Benemenn/autocrib/README.md

Die Dokumentation ist [hier](https://benemenn.github.io/autocrib/) einzusehen!
