Benemenn/autocrib/CAD/CoinSensorTray/CoinSensorTray.png

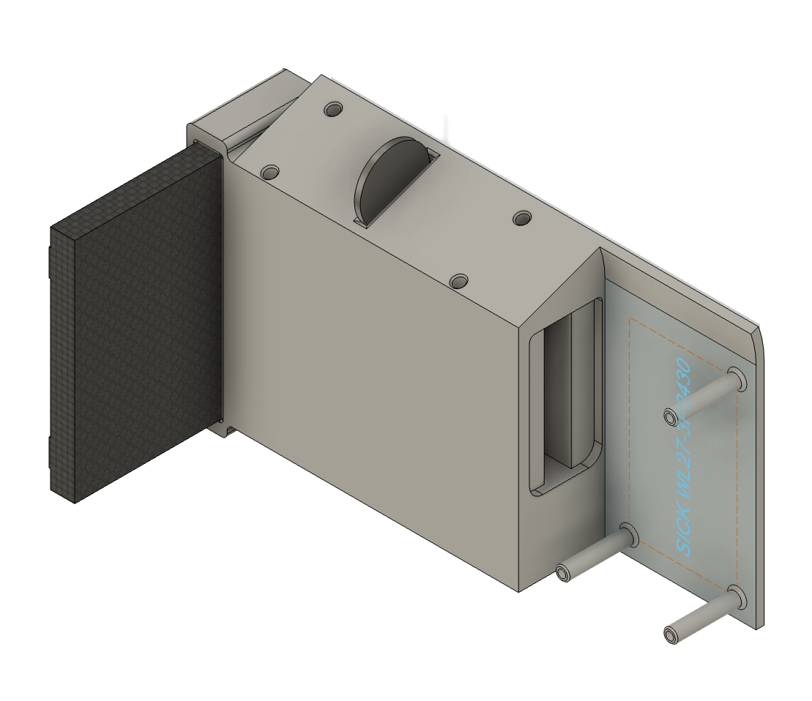
CAD/CoinSensorTray/CoinSensorTray.png
