Benemenn/autocrib/images/Kreppchen_ganz.jpeg

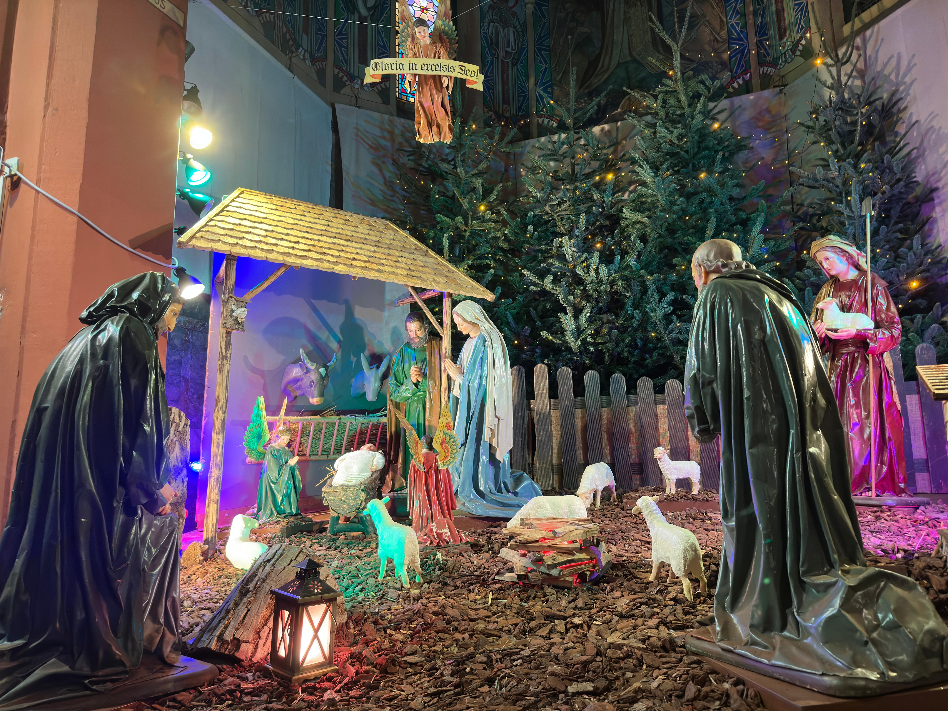
images/Kreppchen_ganz.jpeg
