Benemenn/autocrib/CAD/CoinSensorTray/CoinSensorTray v1.stl

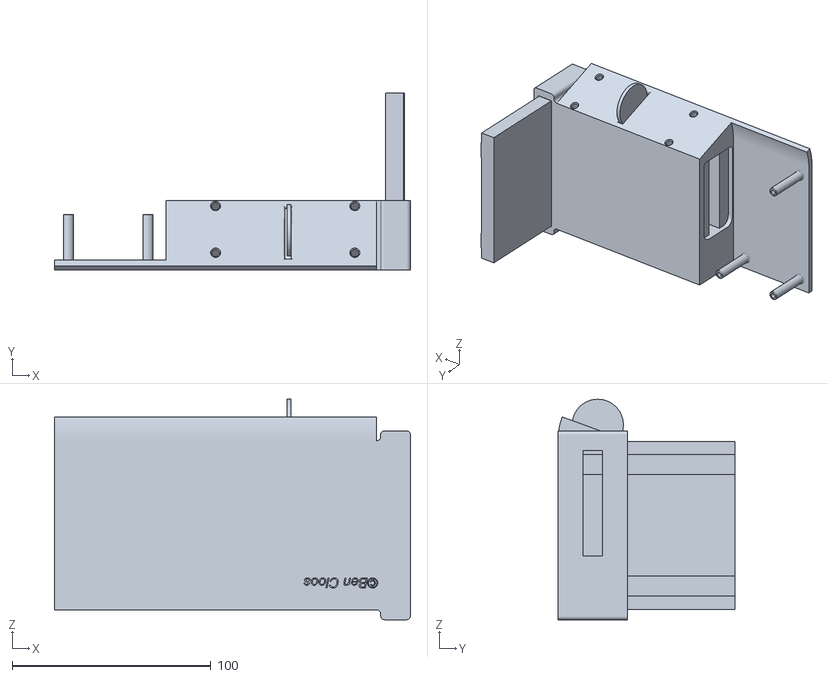
[picture p12: CAD file, 2024-05-11]
CAD/CoinSensorTray/CoinSensorTray v1.stl
179.0 x 89.0 x 110.9
