Benemenn/autocrib/(list of files, cad)

Other CAD files:
CAD/CoinSensorTray/CoinSensorTray v1.f3d
