Benemenn/autocrib/(commit log)

2024-05-11 add CAD for SoinSensorTray
    [CoinSensorTray v1.f3d, CoinSensorTray v1.stl]
2024-05-11 Sensor Doku
2024-05-11 with coin
    [CoinSensorTray v1.f3d, CoinSensorTray v1.stl]
